danielgut12/ECE445_Casinova/Image_Processing_Code/5.jpg

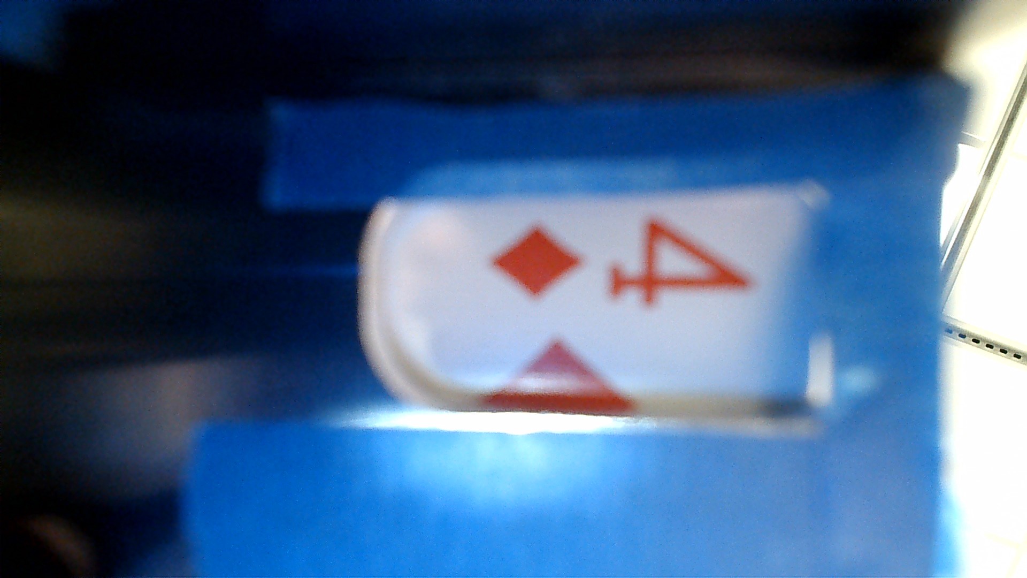
Image_Processing_Code/5.jpg
