danielgut12/ECE445_Casinova/notebooks/mttzeng2/code/demo.png

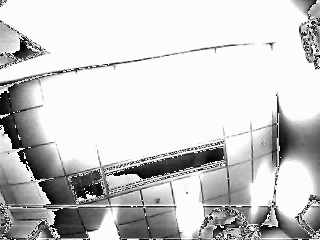
notebooks/mttzeng2/code/demo.png
