danielgut12/ECE445_Casinova/notebooks/mttzeng2/code/frame.png

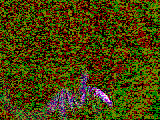
notebooks/mttzeng2/code/frame.png
