danielgut12/ECE445_Casinova/notebooks/mttzeng2/code/frame_fixed.png

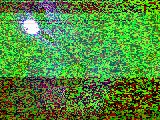
notebooks/mttzeng2/code/frame_fixed.png
