danielgut12/ECE445_Casinova/notebooks/mttzeng2/code/frame_qvga_fixed3.png

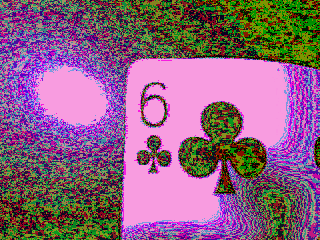
notebooks/mttzeng2/code/frame_qvga_fixed3.png
