danielgut12/ECE445_Casinova/notebooks/mttzeng2/code/frame_qvga_grayscale.png

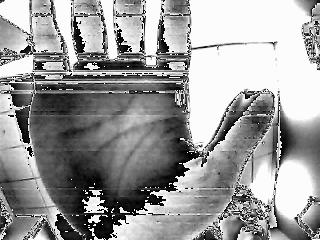
notebooks/mttzeng2/code/frame_qvga_grayscale.png
