danielgut12/ECE445_Casinova/Image_Processing_Code/tutorial.txt

In Powershell
    Set-ExecutionPolicy -Scope Process -ExecutionPolicy Bypass
    cd "C:\path\to\emsdk"
    .\emsdk_env.ps1
