danielgut12/ECE445_Casinova/Image_Processing_Code/testCard2.png

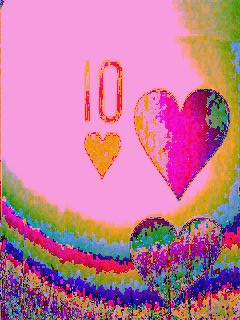
Image_Processing_Code/testCard2.png
