danielgut12/ECE445_Casinova/Image_Processing_Code/testCard3.png

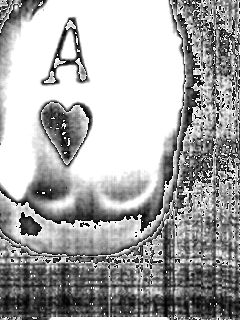
Image_Processing_Code/testCard3.png
