danielgut12/ECE445_Casinova/Image_Processing_Code/testcard4.jpg

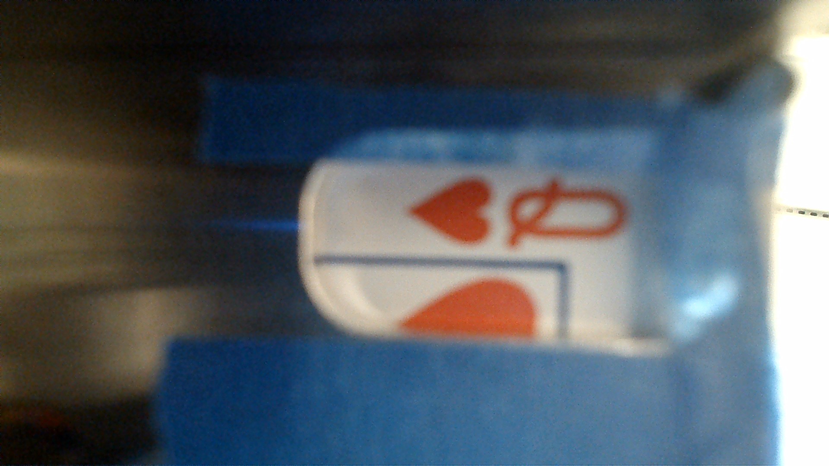
Image_Processing_Code/testcard4.jpg
