danielgut12/ECE445_Casinova/Schematic.pdf

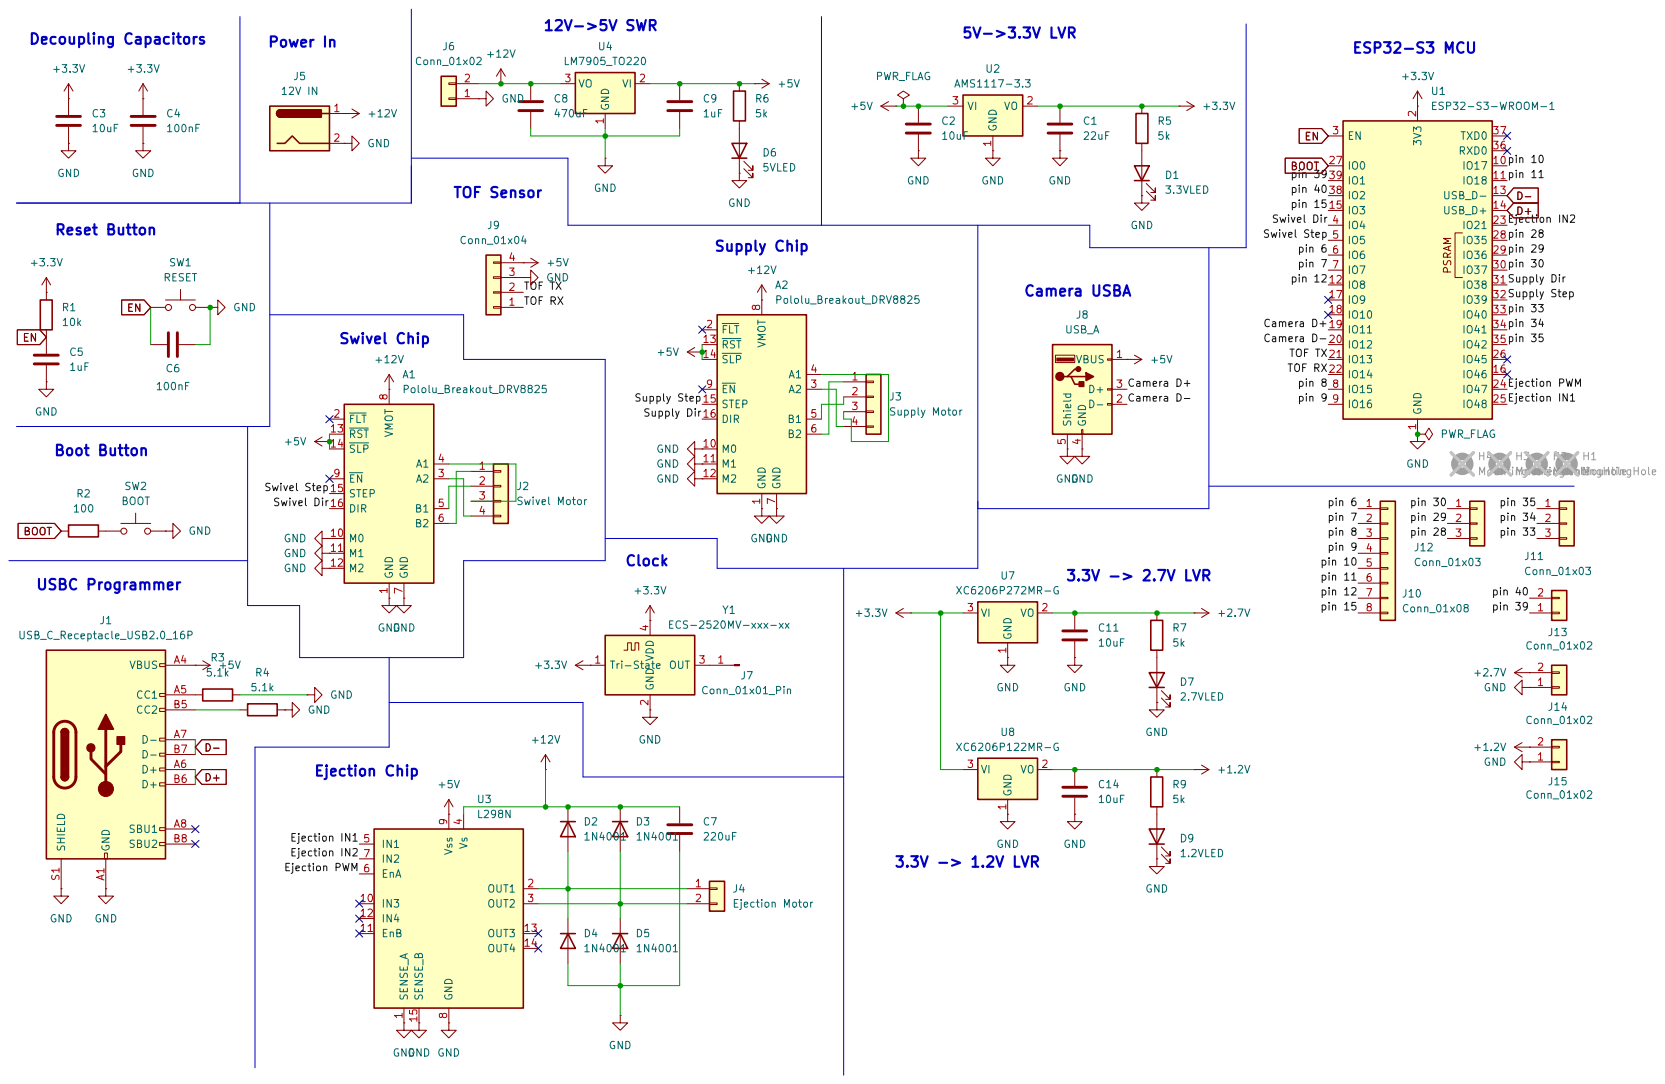
[picture p27: page 1]
