danielgut12/ECE445_Casinova/KiCad Schematics/ECE445_CasinovaV8/casinova_kicad_pcb.kicad_pcb

## KiCad design KiCad Schematics/ECE445_CasinovaV8/casinova_kicad_pcb.kicad_pcb (2025-05-09)

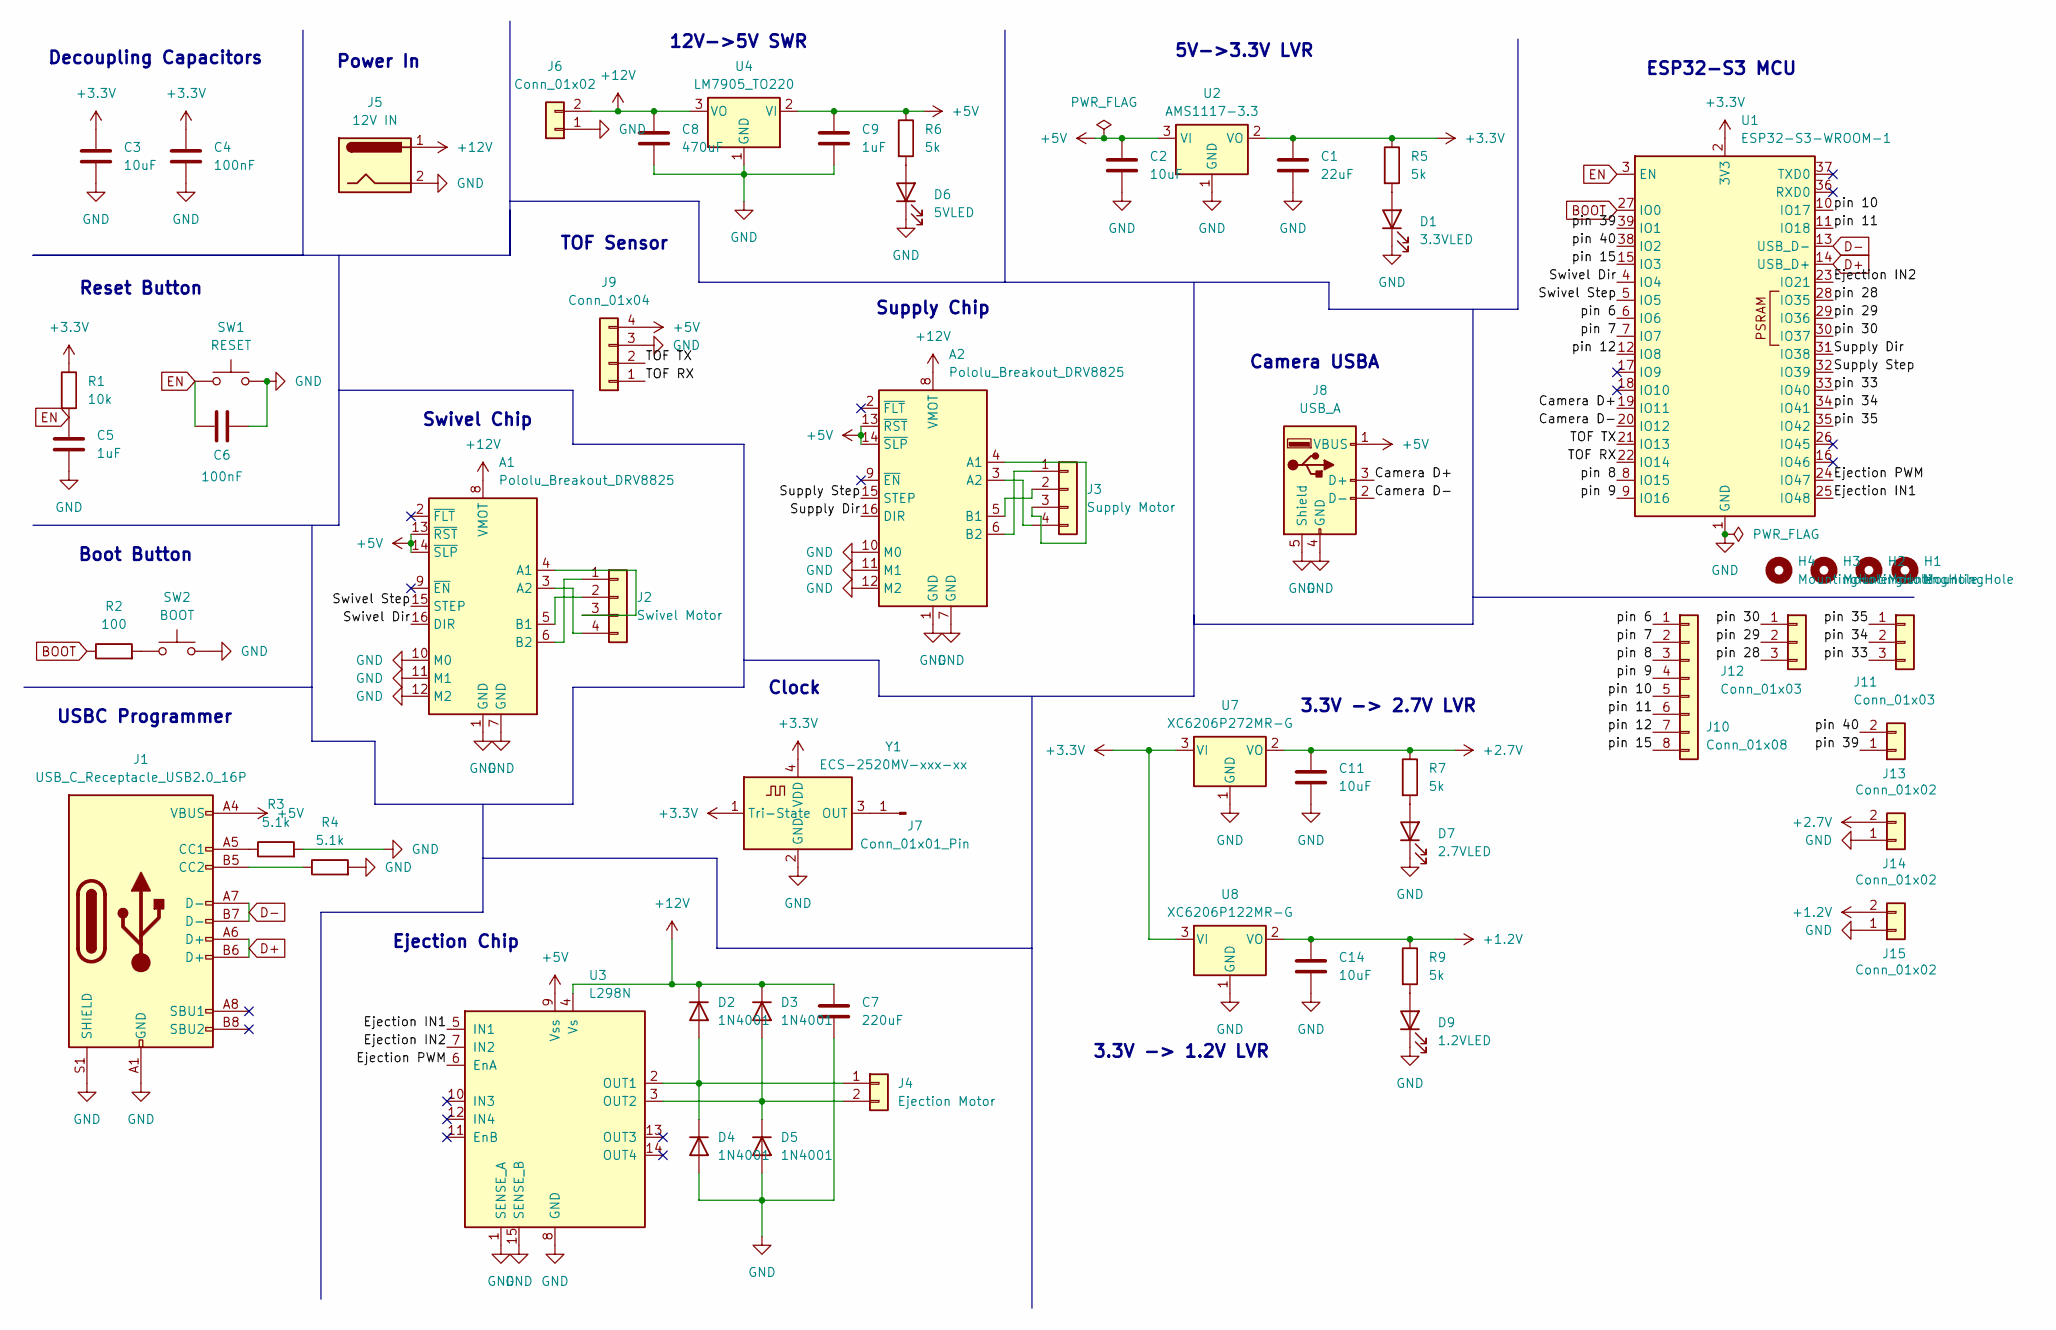
[picture p28: schematic casinova_kicad_pcb.kicad_sch]

Parts:
A1, A2: Pololu_Breakout_DRV8825; Pololu_Breakout-16_15.2x20.3mm
C1: 22uF; C_0805_2012Metric_Pad1.18x1.45mm_HandSolder
C2, C3, C11, C14: 10uF; C_0805_2012Metric_Pad1.18x1.45mm_HandSolder
C4, C6: 100nF; C_0805_2012Metric_Pad1.18x1.45mm_HandSolder
C5, C9: 1uF; C_0805_2012Metric_Pad1.18x1.45mm_HandSolder
C7: 220uF; C_0805_2012Metric_Pad1.18x1.45mm_HandSolder
C8: 470uF; CP_Radial_D8.0mm_P3.50mm
D1: 3.3VLED; LED_0805_2012Metric_Pad1.15x1.40mm_HandSolder
D2, D3, D4, D5: 1N4001; D_DO-41_SOD81_P10.16mm_Horizontal
D6: 5VLED; LED_0805_2012Metric_Pad1.15x1.40mm_HandSolder
D7: 2.7VLED; LED_0805_2012Metric_Pad1.15x1.40mm_HandSolder
D9: 1.2VLED; LED_0805_2012Metric_Pad1.15x1.40mm_HandSolder
H1, H2, H3, H4: MountingHole; MountingHole_3.2mm_M3
J1: USB_C_Receptacle_USB2.0_16P; USB_C_Receptacle_GCT_USB4085
J2: Swivel Motor; Molex_KK-254_AE-6410-04A_1x04_P2.54mm_Vertical
J3: Supply Motor; Molex_KK-254_AE-6410-04A_1x04_P2.54mm_Vertical
J4: Ejection Motor; Molex_KK-254_AE-6410-02A_1x02_P2.54mm_Vertical
J5: 12V IN; BarrelJack_SwitchcraftConxall_RAPC10U_Horizontal
J6, J13, J14, J15: Conn_01x02; Molex_KK-254_AE-6410-02A_1x02_P2.54mm_Vertical
J7: Conn_01x01_Pin; PinHeader_1x01_P1.00mm_Vertical
J8: USB_A; USB_A_Molex_48037-2200_Horizontal
J9: Conn_01x04; Molex_KK-254_AE-6410-04A_1x04_P2.54mm_Vertical
J10: Conn_01x08; Molex_KK-254_AE-6410-08A_1x08_P2.54mm_Vertical
J11, J12: Conn_01x03; Molex_KK-254_AE-6410-03A_1x03_P2.54mm_Vertical
R1: 10k; R_0805_2012Metric_Pad1.20x1.40mm_HandSolder
R2: 100; R_0805_2012Metric_Pad1.20x1.40mm_HandSolder
R3, R4: 5.1k; R_0805_2012Metric_Pad1.20x1.40mm_HandSolder
R5, R6, R7, R9: 5k; R_0805_2012Metric_Pad1.20x1.40mm_HandSolder
SW1: RESET; SW_SPST_PTS645
SW2: BOOT; SW_SPST_PTS645
U1: ESP32-S3-WROOM-1
U2: AMS1117-3.3; SOT-223-3_TabPin2
U3: L298N; TO-220-15_P2.54x5.08mm_StaggerOdd_Lead4.58mm_Vertical
U4: LM7905_TO220; TO-220-3_Vertical
U7: XC6206P272MR-G; SOT-23-3
U8: XC6206P122MR-G; SOT-23-3
Y1: ECS-2520MV-xxx-xx; Oscillator_SMD_ECS_2520MV-xxx-xx-4Pin_2.5x2.0mm

Connections:
+1.2V: C14.1, J15.2, R9.1, U8.2 (VO)
+2.7V: C11.1, J14.2, R7.1, U7.2 (VO)
+3.3V: C1.1, C3.1, C4.1, R1.1, R5.1, U1.2 (3V3), U2.2 (VO), U7.3 (VI), U8.3 (VI), Y1.1 (Tri-State), Y1.4 (VDD)
+5V: A1.13 (~RST), A1.14 (~SLP), A2.13 (~RST), A2.14 (~SLP), C2.1, C9.1, J1.A4 (VBUS), J1.A9 (VBUS), J1.B4 (VBUS), J1.B9 (VBUS), J8.1 (VBUS), J9.4, R6.1, U2.3 (VI), U3.9 (Vss), U4.2 (VI)
+12V: A1.8 (VMOT), A2.8 (VMOT), C7.1, C8.1, D2.1 (K), D3.1 (K), J5.1, J6.2, U3.4 (Vs), U4.3 (VO)
/Camera D+: J8.3 (D+), U1.19 (IO11)
/Camera D-: J8.2 (D-), U1.20 (IO12)
/Ejection IN1: U1.25 (IO48), U3.5 (IN1)
/Ejection IN2: U1.23 (IO21), U3.7 (IN2)
/Ejection PWM: U1.24 (IO47), U3.6 (EnA)
/Supply Dir: A2.16 (DIR), U1.31 (IO38)
/Supply Step: A2.15 (STEP), U1.32 (IO39)
/Swivel Dir: A1.16 (DIR), U1.4 (IO4)
/Swivel Step: A1.15 (STEP), U1.5 (IO5)
/TOF RX: J9.1, U1.22 (IO14)
/TOF TX: J9.2, U1.21 (IO13)
/pin 6: J10.1, U1.6 (IO6)
/pin 7: J10.2, U1.7 (IO7)
/pin 8: J10.3, U1.8 (IO15)
/pin 9: J10.4, U1.9 (IO16)
/pin 10: J10.5, U1.10 (IO17)
/pin 11: J10.6, U1.11 (IO18)
/pin 12: J10.7, U1.12 (IO8)
/pin 15: J10.8, U1.15 (IO3)
/pin 28: J12.3, U1.28 (IO35)
/pin 29: J12.2, U1.29 (IO36)
/pin 30: J12.1, U1.30 (IO37)
/pin 33: J11.3, U1.33 (IO40)
/pin 34: J11.2, U1.34 (IO41)
/pin 35: J11.1, U1.35 (IO42)
/pin 39: J13.1, U1.39 (IO1)
/pin 40: J13.2, U1.38 (IO2)
BOOT: R2.1, U1.27 (IO0)
D+: J1.A6 (D+), J1.B6 (D+), U1.14 (USB_D+)
D-: J1.A7 (D-), J1.B7 (D-), U1.13 (USB_D-)
EN: C5.1, C6.2, R1.2, SW1.1, U1.3 (EN)
GND: A1.1 (GND), A1.7 (GND), A1.10 (M0), A1.11 (M1), A1.12 (M2), A2.1 (GND), A2.7 (GND), A2.10 (M0), A2.11 (M1), A2.12 (M2), C1.2, C2.2, C3.2, C4.2, C5.2, C6.1, C7.2, C8.2, C9.2, C11.2, C14.2, D1.1 (K), D4.2 (A), D5.2 (A), D6.1 (K), D7.1 (K), D9.1 (K), J1.A1 (GND), J1.A12 (GND), J1.B1 (GND), J1.B12 (GND), J1.S1 (SHIELD), J5.2, J6.1, J8.4 (GND), J8.5 (Shield), J9.3, J14.1, J15.1, R3.2, R4.2, SW1.2, SW2.2, U1.1 (GND), U1.40 (GND), U1.41 (GND), U2.1 (GND), U3.1 (SENSE_A), U3.8 (GND), U3.15 (SENSE_B), U4.1 (GND), U7.1 (GND), U8.1 (GND), Y1.2 (GND)
unnamed: A1.4 (A1), J2.3
unnamed: A1.3 (A2), J2.4
unnamed: A1.5 (B1), J2.2
unnamed: A1.6 (B2), J2.1
unnamed: A2.4 (A1), J3.3
unnamed: A2.3 (A2), J3.4
unnamed: A2.5 (B1), J3.2
unnamed: A2.6 (B2), J3.1
unnamed: D1.2 (A), R5.2
unnamed: D2.2 (A), D4.1 (K), J4.1, U3.2 (OUT1)
unnamed: D3.2 (A), D5.1 (K), J4.2, U3.3 (OUT2)
unnamed: D6.2 (A), R6.2
unnamed: D7.2 (A), R7.2
unnamed: D9.2 (A), R9.2
unnamed: J1.A5 (CC1), R3.1
unnamed: J1.B5 (CC2), R4.1
unnamed: J7.1, Y1.3 (OUT)
unnamed: R2.2, SW2.1

Notes on the sheet:
Reset Button
5V->3.3V LVR
TOF Sensor
USBC Programmer
Supply Chip
3.3V -> 1.2V LVR
12V->5V SWR
Decoupling Capacitors
Ejection Chip
Clock
ESP32-S3 MCU
Boot Button
Camera USBA
Swivel Chip
Power In
3.3V -> 2.7V LVR

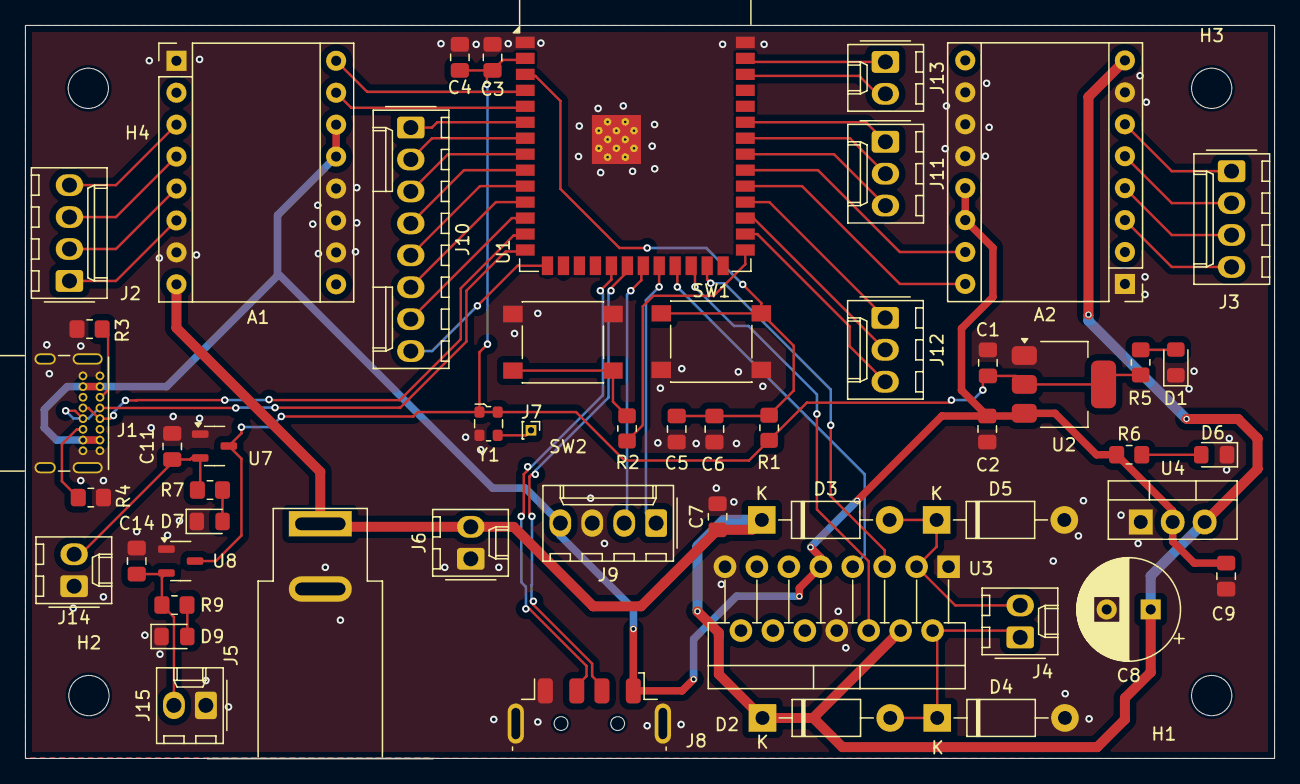
[picture p29: board casinova_kicad_pcb.kicad_pcb from above]

Board: 2 copper layers, 99.3 x 58.3 mm, 57 parts (0 on the bottom side), 55 nets.
