danielgut12/ECE445_Casinova/Casinova/src/motors.h

#ifndef MOTORS_H
#define MOTORS_H


void initMotors();
void ejectCard(int power);
void makeQuarterTurnCW();
void makeQuarterTurnCCW();
void resetToStart();
void setupSwivel();
void rotateStepper(int degrees);
void rotateToPlayer(int playerIndex, int totalPlayers);
void rotateByDegrees(float degrees);
void setupEjection();
void runEjection(int distance_mm);
void pushCardsWithDistance();
void rotateToBoard();
void queueCard();

#endif
