danielgut12/ECE445_Casinova/(commit log)

2025-03-04 fixed schematic png for README
2025-03-05 added TOF sensor code
2025-03-11 testing motor
2025-03-27 basic camera code
2025-04-14 redid camera org
2025-04-14 readded TOF sensor capabilities
2025-04-17 motor logic test
2025-04-24 used camera images for processing
2025-04-25 fixed ready state on load
    [my_wifi.cpp]
2025-04-26 poker games reset correctly after rounds
    [card.cpp, game.cpp, my_wifi.cpp]
2025-04-26 added commented hole card dealing
2025-04-27 tof sensor works again
2025-04-27 tof sensor updates to latest distance
2025-04-27 queue motor runs on queue button function
2025-04-27 accell and decell for queue motor (more reliable)
2025-04-27 queue motor constant go demo
2025-04-27 pcb stuff
    [casinova_kicad_pcb.kicad_pcb, casinova_kicad_pcb.kicad_sch]
2025-04-28 supply motor pcb demo code
2025-04-28 added PWM features
