danielgut12/ECE445_Casinova/notebooks/danielg9/media/Nema17StepperMotorArdiunoSetup.JPG

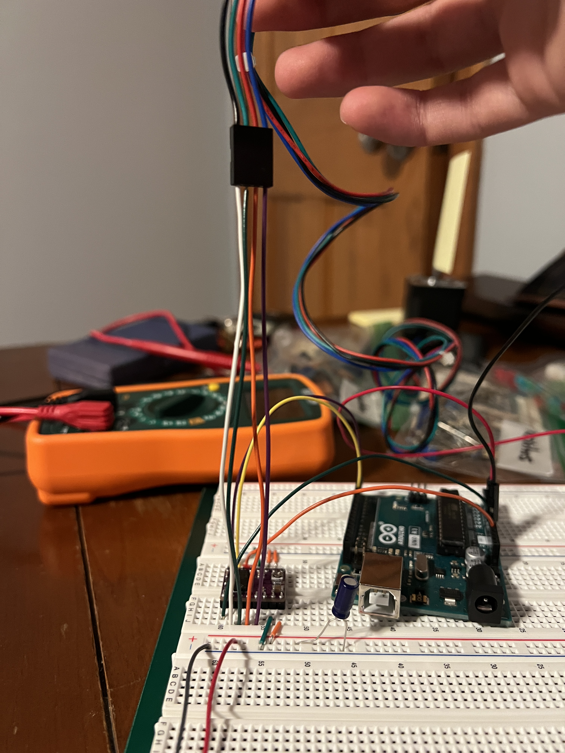
[picture p9: notebooks/danielg9/media/Nema17StepperMotorArdiunoSetup.JPG]
notebooks/danielg9/media/Nema17StepperMotorArdiunoSetup.JPG
