danielgut12/ECE445_Casinova/notebooks/danielg9/media/FinalCase.JPG

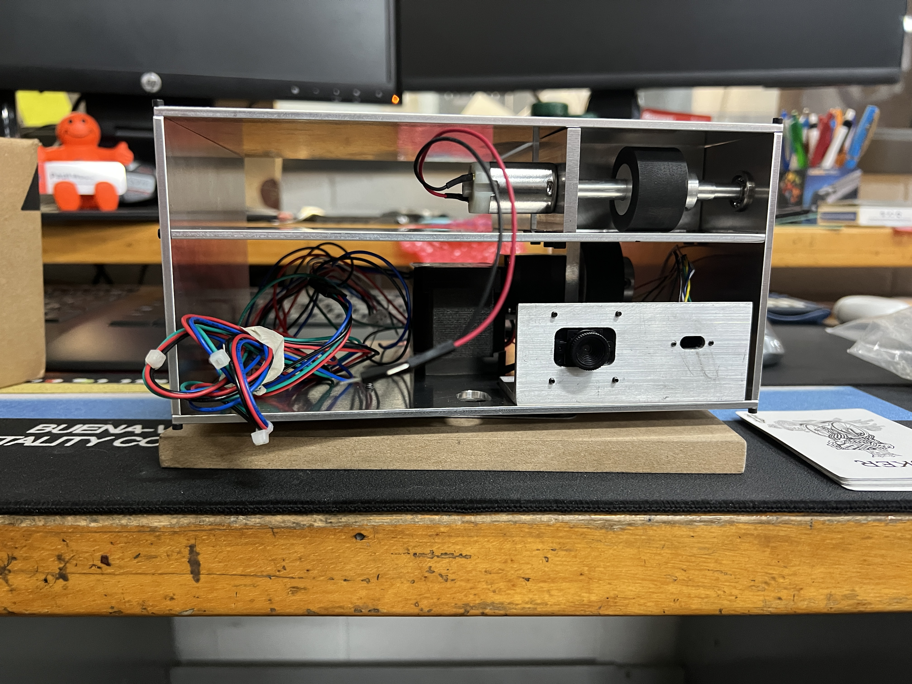
[picture p10: notebooks/danielg9/media/FinalCase.JPG]
notebooks/danielg9/media/FinalCase.JPG
