danielgut12/ECE445_Casinova/notebooks/danielg9/media/FirstDraftPCBSolder.JPG

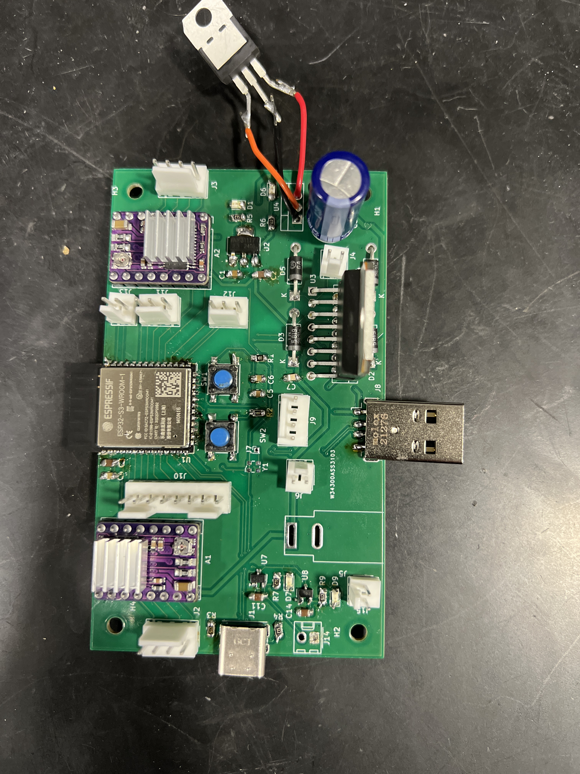
[picture p12: notebooks/danielg9/media/FirstDraftPCBSolder.JPG]
notebooks/danielg9/media/FirstDraftPCBSolder.JPG
